vadimkim/indoor-monitor/pictures/IMG_0093.JPG

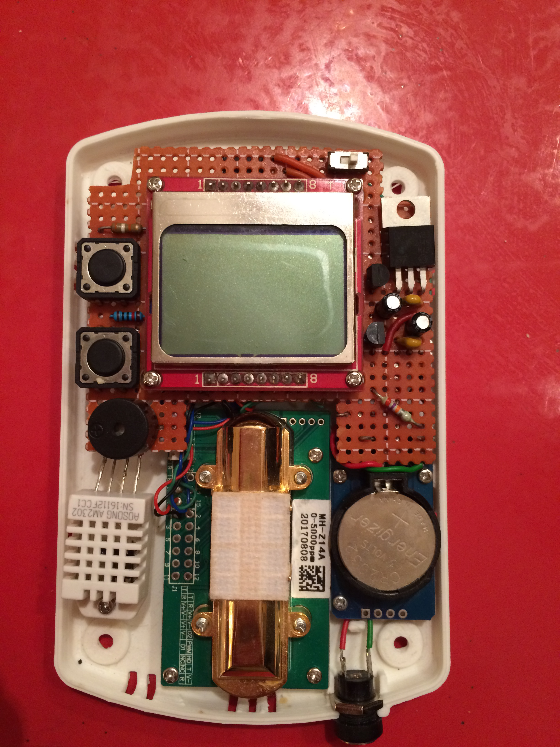
pictures/IMG_0093.JPG
