vadimkim/indoor-monitor/pictures/IMG_0092.JPG

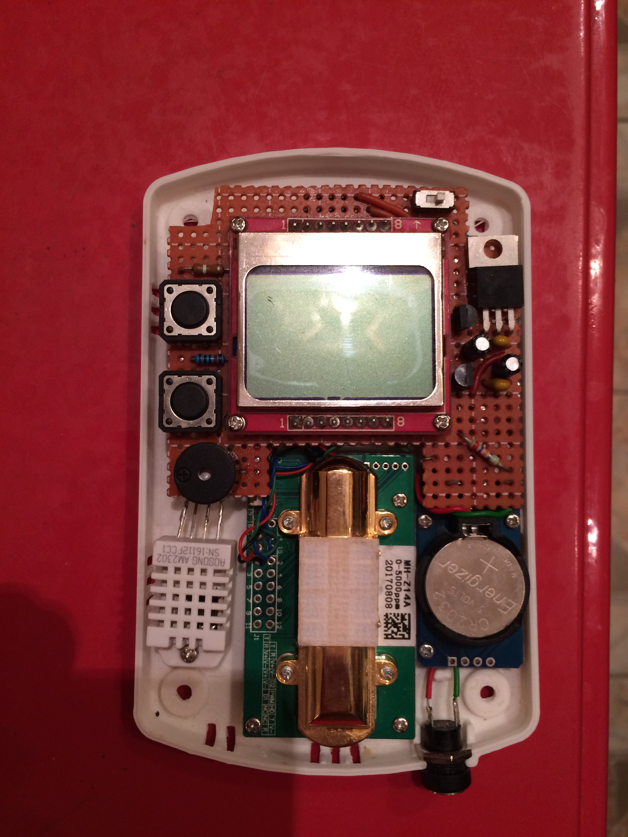
pictures/IMG_0092.JPG
