vadimkim/indoor-monitor/README.md

# indoor-monitor
Home weather station. Monitors CO2, temperature and humidity
