vadimkim/indoor-monitor/pictures/IMG_0094.JPG

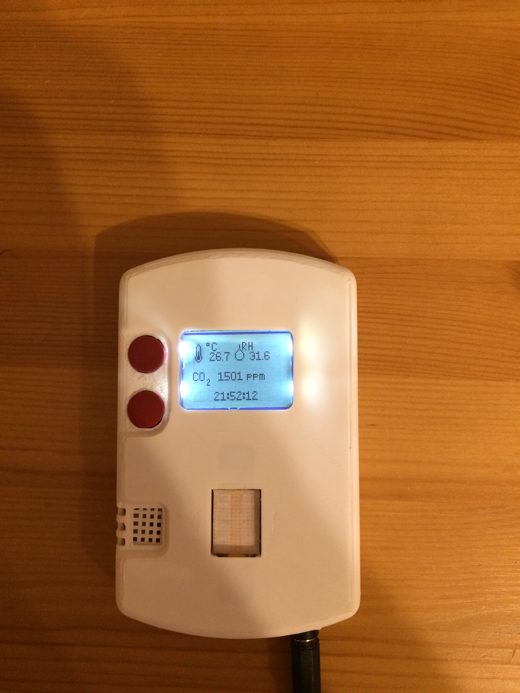
pictures/IMG_0094.JPG
