vadimkim/indoor-monitor/pictures/IMG_0096.JPG

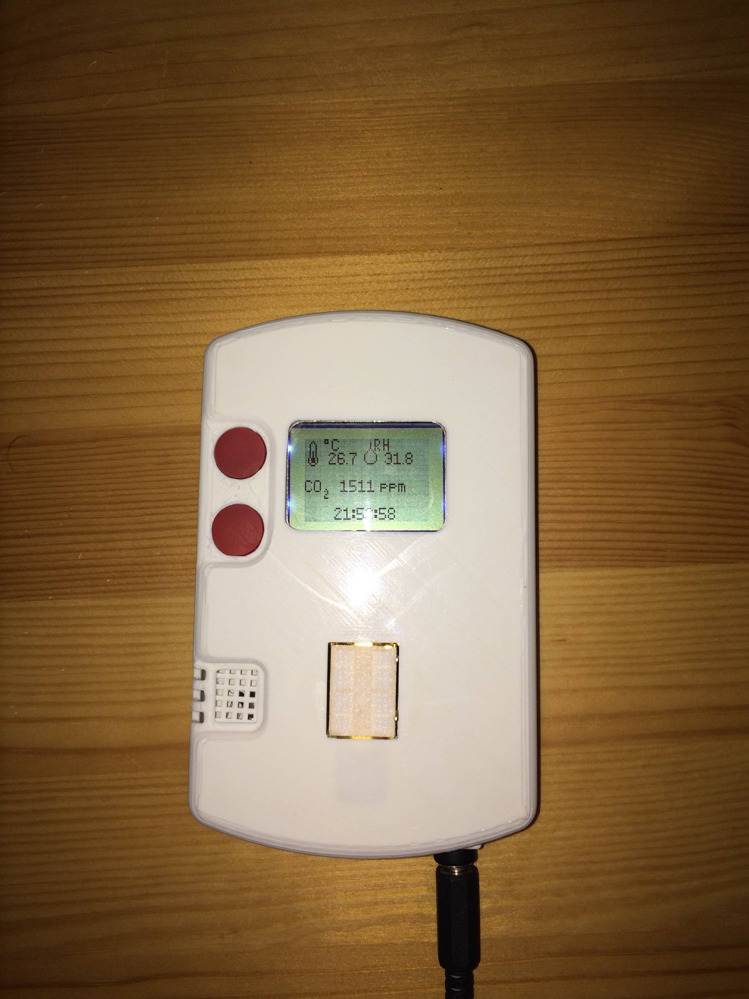
pictures/IMG_0096.JPG
