vadimkim/indoor-monitor/hull/cover.stl

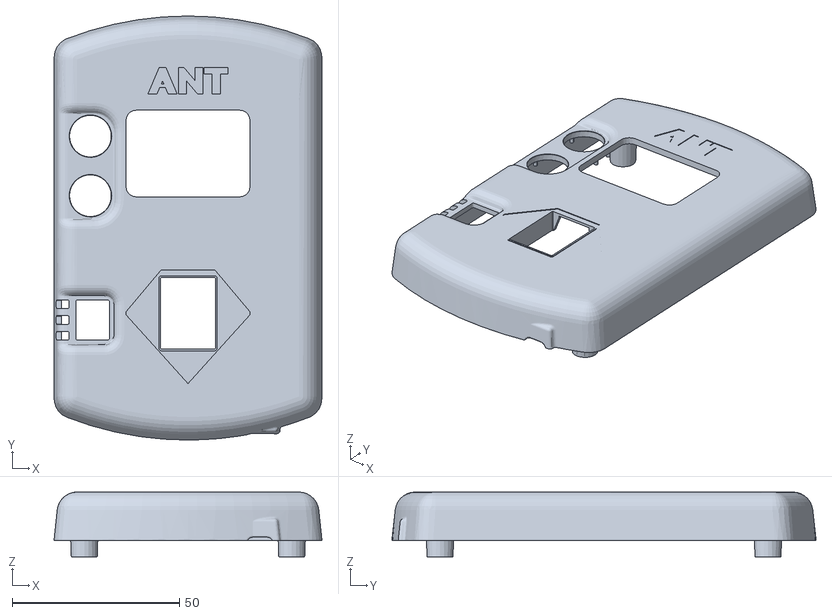
[picture p5: CAD file, 2019-11-29]
hull/cover.stl
80.0 x 126.7 x 19.4
