vadimkim/indoor-monitor/hull/base.stl

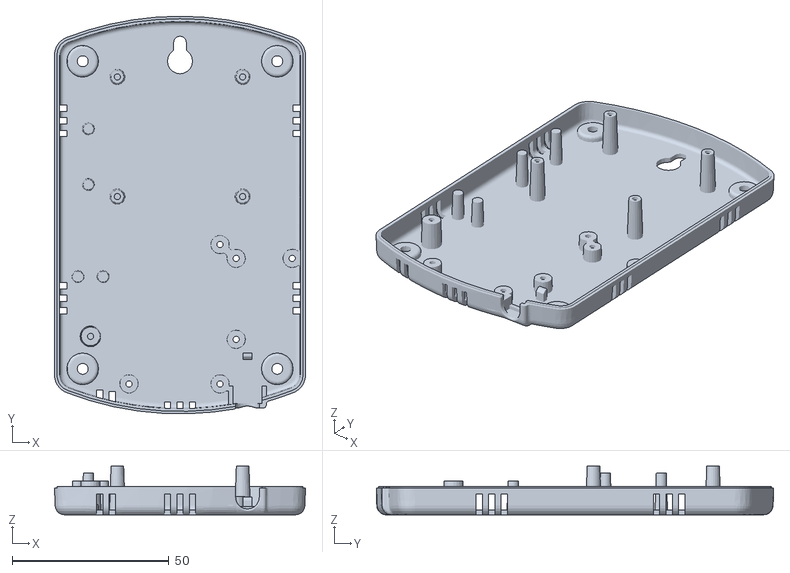
[picture p6: CAD file, 2019-11-29]
hull/base.stl
80.0 x 126.6 x 15.5
