vadimkim/indoor-monitor/eagle/sensor.sch

## EAGLE design eagle/sensor.sch (2018-11-16)

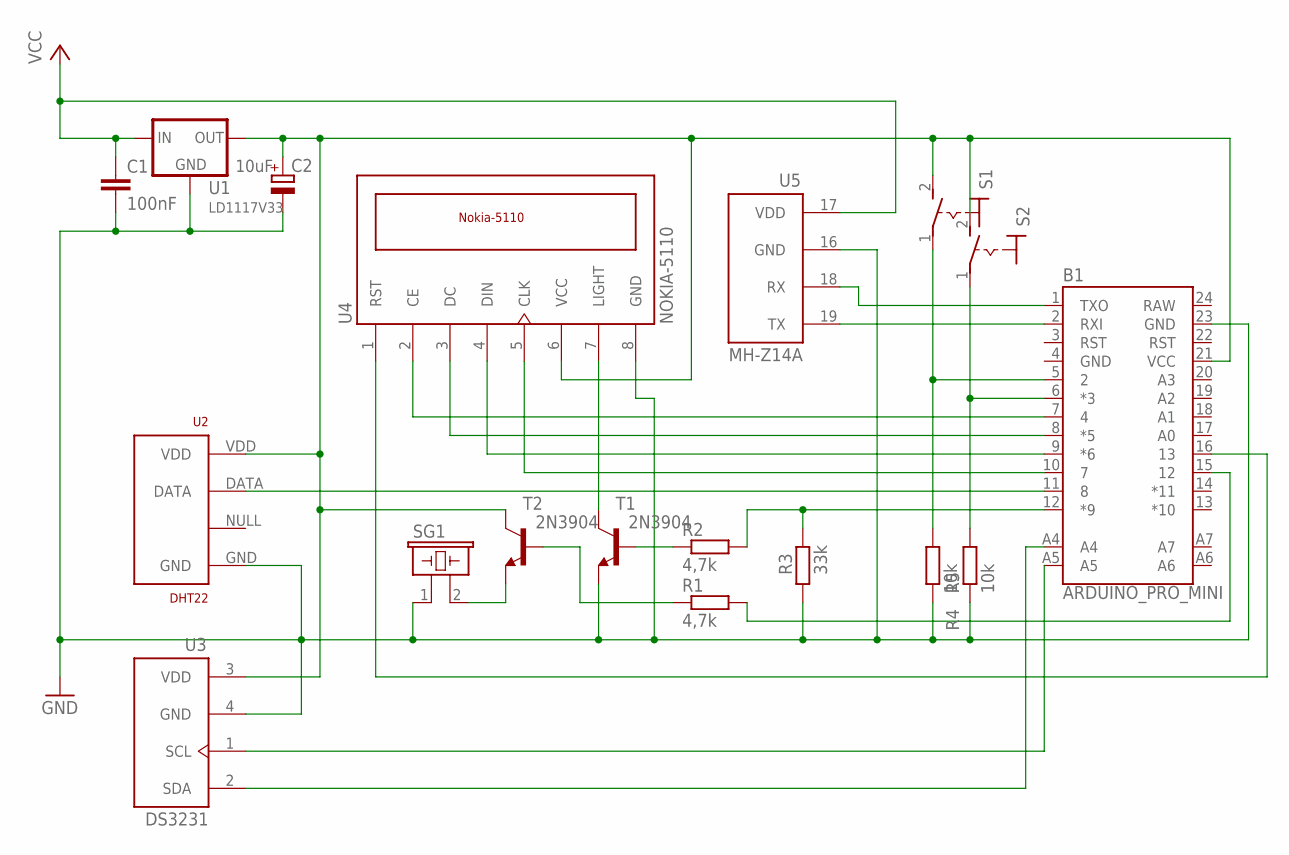
[picture p7: schematic sensor.sch]

Parts:
B1: ARDUINO_PRO_MINI
C1: 100nF; C025-040X050
C2: 10uF; E2-5
R1, R2: 4,7k; 0207/15
R3: 33k; 0207/15
R4, R5: 10k; 0207/15
S1, S2: MS243
SG1: F/EE21P
T1, T2: 2N3904; TO92
U1: LD1117V33; 78XXL
U2: DHT22; RHT03_DHT-22
U3: DS3231
U4: NOKIA-5110; SHIELD-NOKIA
U5: MH-Z14

Connections:
GND: B1.23 (GND), C1.2, C2.-, R3.1, R4.1, R5.1, SG1.1, T1.3 (E), U1.IN (GND), U2.GND, U3.4 (GND), U4.8 (GND), U5.16 (GND)
unnamed: B1.16 (13), U4.1 (RST)
unnamed: B1.7 (4), U4.2 (CE)
unnamed: B1.8 (*5), U4.3 (DC)
unnamed: B1.9 (*6), U4.4 (DIN)
unnamed: B1.10 (7), U4.5 (CLK)
unnamed: R2.1, T1.2 (B)
unnamed: T1.1 (C), U4.7 (LIGHT)
unnamed: B1.12 (*9), R2.2, R3.2
unnamed: B1.2 (RXI), U5.19 (TX)
unnamed: B1.11 (8), U2.DATA
unnamed: B1.1 (TXO), U5.18 (RX)
unnamed: B1.5 (2), R4.2, S1.1
unnamed: B1.6 (*3), R5.2, S2.1
unnamed: B1.15 (12), R1.2
unnamed: B1.A5, U3.1 (SCL)
unnamed: B1.A4, U3.2 (SDA)
unnamed: SG1.2, T2.3 (E)
unnamed: R1.1, T2.2 (B)
VCC: C1.1, U1.OUT (IN), U5.17 (VDD)
VCC33: B1.21 (VCC), C2.+, S1.2 (S), S2.2 (S), T2.1 (C), U1.GND (OUT), U2.VDD, U3.3 (VDD), U4.6 (VCC)
