vadimkim/indoor-monitor/(commit log)

2018-05-01 working prototype w/o buttons
2018-11-16 formating, backlight warn fix
    [MicroClimate.ino]
2018-11-16 project files re-structure
    [sensor.sch]
2018-12-02 moved to sub-folder
    fixed counter variables
    [MicroClimate.ino]
2019-11-21 added 3d model and final product pictures
    [base.stl, cover.stl]
